jyancat/EC-Debug/3D Printer Files/EC Debug.step

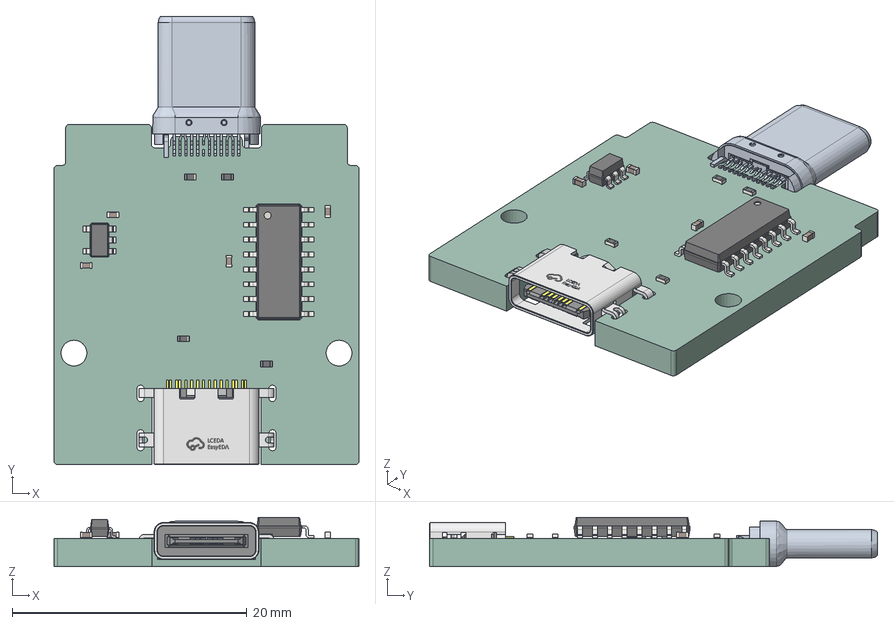
[picture p1: CAD file, 2024-08-14]
3D Printer Files/EC Debug.step
26.0 x 38.2 x 4.20 mm
R_0402_1005Metric x 4
C_0402_1005Metric x 4
USB-TYPE-C-SMD_GT-USB-7014F
SOT_23_5
SOIC_16_39x99mm_P127mm
EC Debug_PCB
