jyancat/EC-Debug/3D Printer Files/Shell.3mf

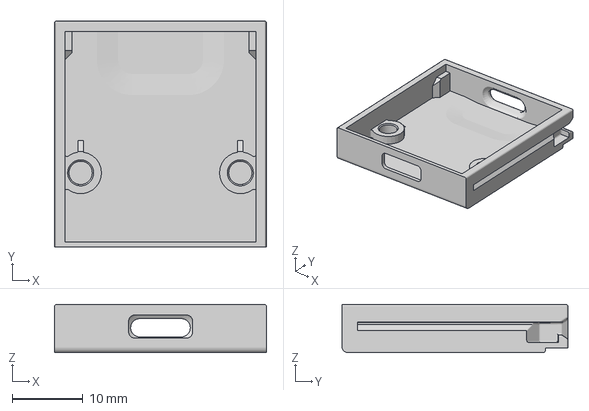
[picture p2: CAD file, 2024-08-14]
3D Printer Files/Shell.3mf
30.0 x 32.0 x 6.80 mm
