jyancat/EC-Debug/3D Printer Files/Lid.3mf

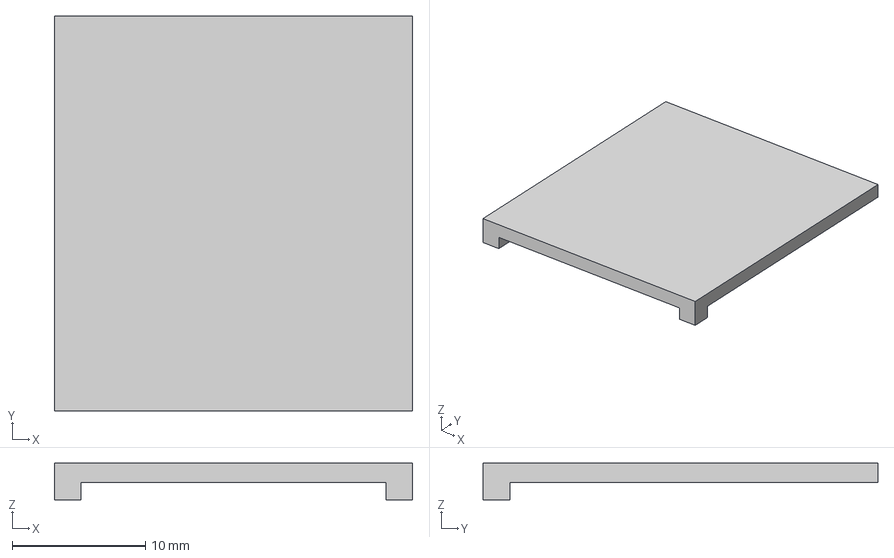
[picture p3: CAD file, 2024-08-14]
3D Printer Files/Lid.3mf
26.9 x 29.6 x 2.75 mm
