jyancat/EC-Debug/Hardware/EC Debug.kicad_pcb

## KiCad design Hardware/EC Debug.kicad_pcb (2024-08-14)

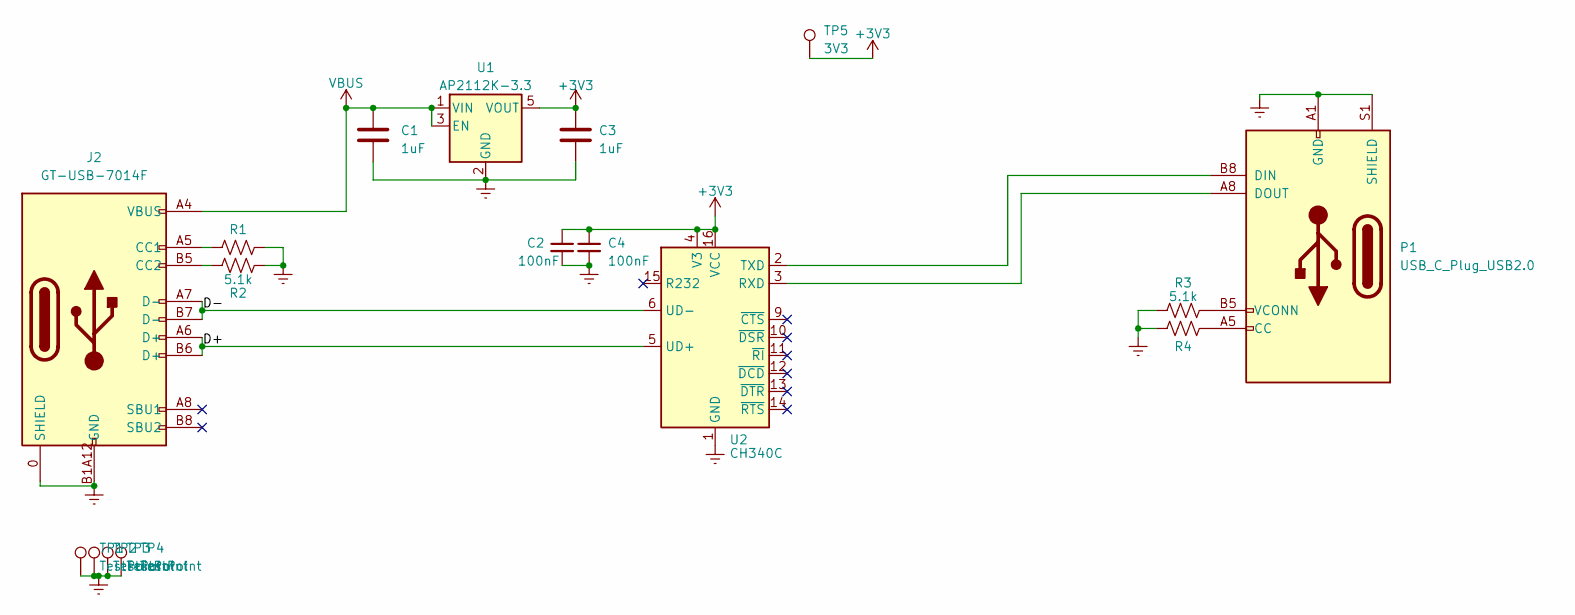
[picture p4: schematic EC Debug.kicad_sch]

Parts:
C1, C3: 1uF; C_0402_1005Metric
C2, C4: 100nF; C_0402_1005Metric
J2: GT-USB-7014F; LCSC Part C3001282
P1: USB_C_Plug_USB2.0; 105444
R1, R2, R3, R4: 5.1k; R_0402_1005Metric
TP1, TP2, TP3, TP4: TestPoint; TestPoint_Pad_1.5x1.5mm
TP5: 3V3; TestPoint_Pad_D1.0mm
U1: AP2112K-3.3; SOT-23-5
U2: CH340C; SOIC-16_3.9x9.9mm_P1.27mm

Connections:
+3V3: C2.1, C3.1, C4.1, TP5.1, U1.5 (VOUT), U2.4 (V3), U2.16 (VCC)
/D+: J2.A6 (D+), J2.B6 (D+), U2.5 (UD+)
/D-: J2.A7 (D-), J2.B7 (D-), U2.6 (UD-)
Earth: C1.2, C2.2, C3.2, C4.2, J2.0 (SHIELD), J2.A1B12 (GND), J2.B1A12 (GND), P1.A1 (GND), P1.A12 (GND), P1.B1 (GND), P1.B12 (GND), P1.S1 (SHIELD), R1.1, R2.1, R3.1, R4.1, TP1.1, TP2.1, TP3.1, TP4.1, U1.2 (GND), U2.1 (GND)
unnamed: J2.A5 (CC1), R1.2
unnamed: J2.B5 (CC2), R2.2
unnamed: P1.A5 (CC), R4.2
unnamed: P1.B8 (DIN), U2.2 (TXD)
unnamed: P1.A8 (DOUT), U2.3 (RXD)
unnamed: P1.B5 (VCONN), R3.2
VBUS: C1.1, J2.A4 (VBUS), J2.B4 (VBUS), U1.1 (VIN), U1.3 (EN)

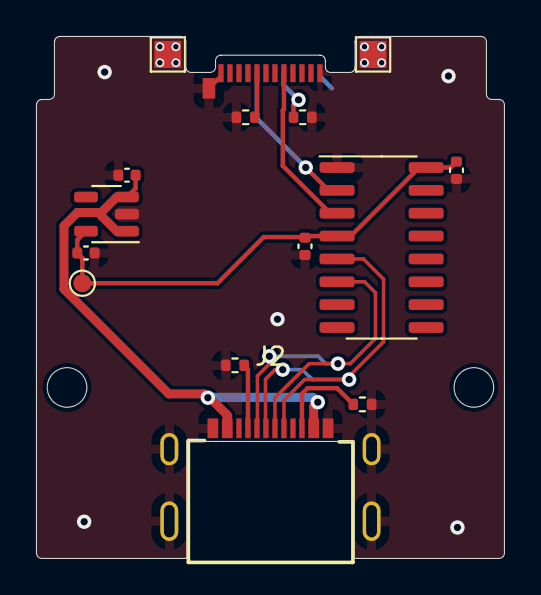
[picture p5: board EC Debug.kicad_pcb from above]

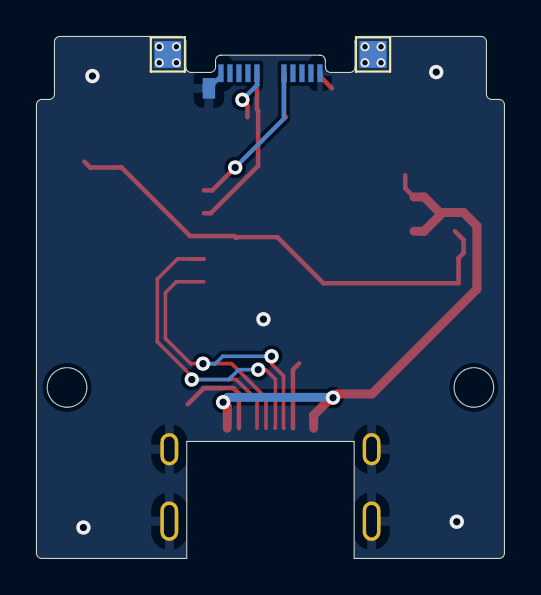
[picture p6: board EC Debug.kicad_pcb from below]

Board: 2 copper layers, 26.0 x 29.0 mm, 19 parts (2 on the bottom side), 11 nets.

Other parts of the board:
H1, H2: MountingHole; MountingHole_2.2mm_M2
